0xtopus/fiber-tapering-machine/Project/FTM_v1.0/readme.txt

用于拉锥机的程序，芯片是STM32F767ZGT6，电路板和原理图请查看“Schematic”文件夹下对应的文件，程序模板使用了正点原子的emWin移植模板，由于引脚和芯片的不同进行了对应的修改以适配硬件，并在此基础上加入了对应的图形界面和逻辑控制，详情请查看“Docs”文件夹下的“CodingSpec.md”文档。
