0xtopus/fiber-tapering-machine/GUI/README.md

用于Visual Studio2019的仿真文件，主要用来查看界面显示的效果并进行微调，并没有实际的功能。

仿真示意图：



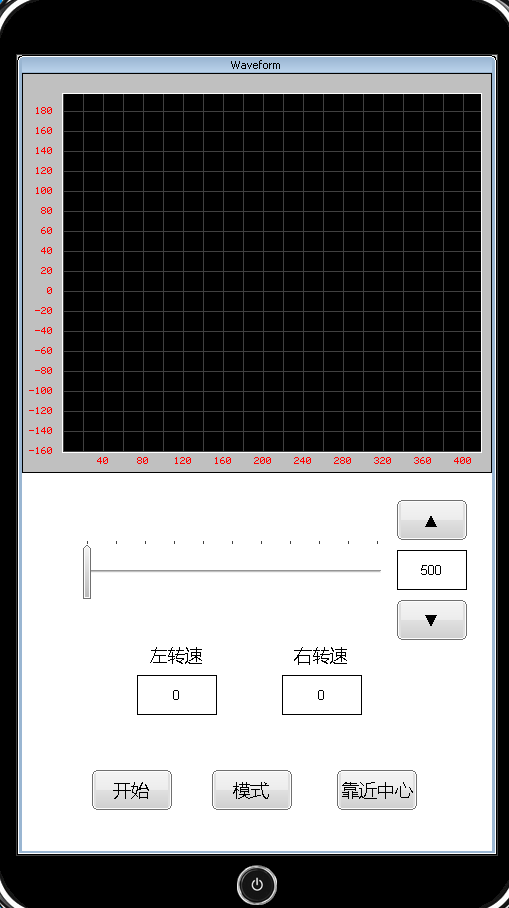
[picture p11: Docs/Images/CodingSpec_img/DualCtrl_Simu.png]
