0xtopus/fiber-tapering-machine/Docs/others/通信总线.md

# CAN总线

## 简介

全称Controller Area Network，是ISO国际标准化的**串行通信协议**。

## 总线拓扑

一、总线电平

- 显性电平
- 隐性电平

CAN控制器根据两根线上的电位差来判断总线电平。发送方通过使总线电平发生变化，将消息发送给接收方。
