0xtopus/fiber-tapering-machine/Docs/Images/SCH_v1.0.png

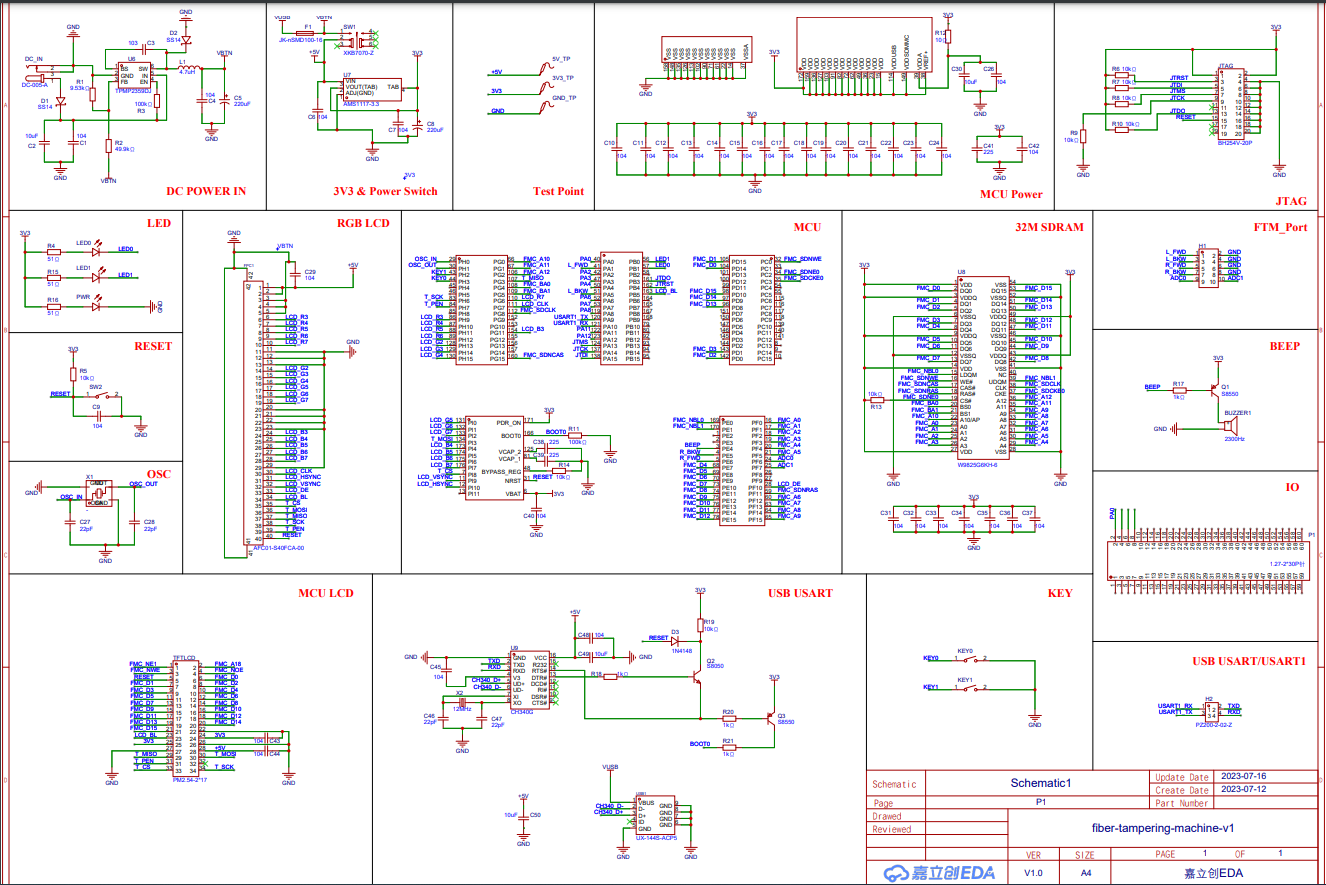
Docs/Images/SCH_v1.0.png
