0xtopus/fiber-tapering-machine/Docs/Images/Schematic_光纤拉锥机_2023-07-21.png

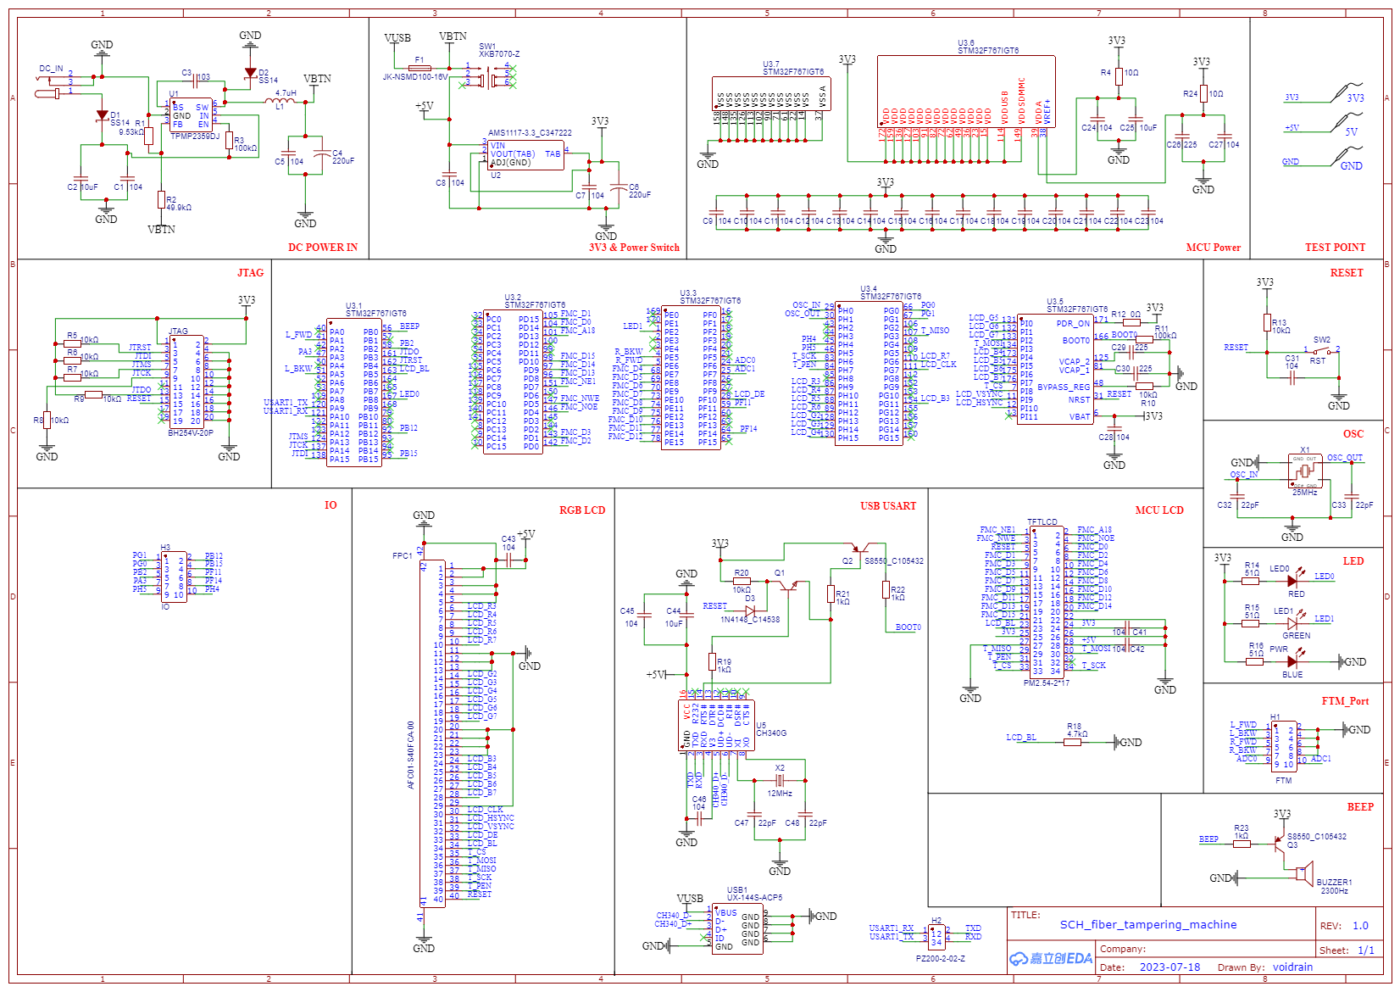
Docs/Images/Schematic_光纤拉锥机_2023-07-21.png
