0xtopus/fiber-tapering-machine/Schematic/PCB_PCB_光纤拉锥机-144pin.pdf

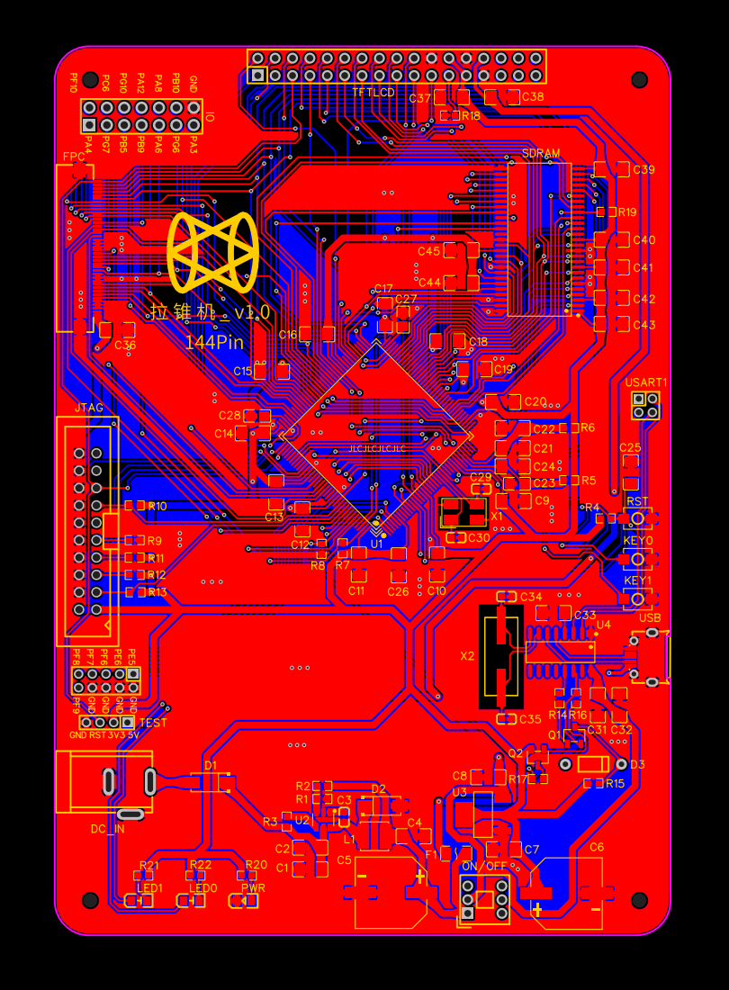
[picture p15: page 1]
