0xtopus/fiber-tapering-machine/Schematic/Schematic_光纤拉锥机-144pin.pdf

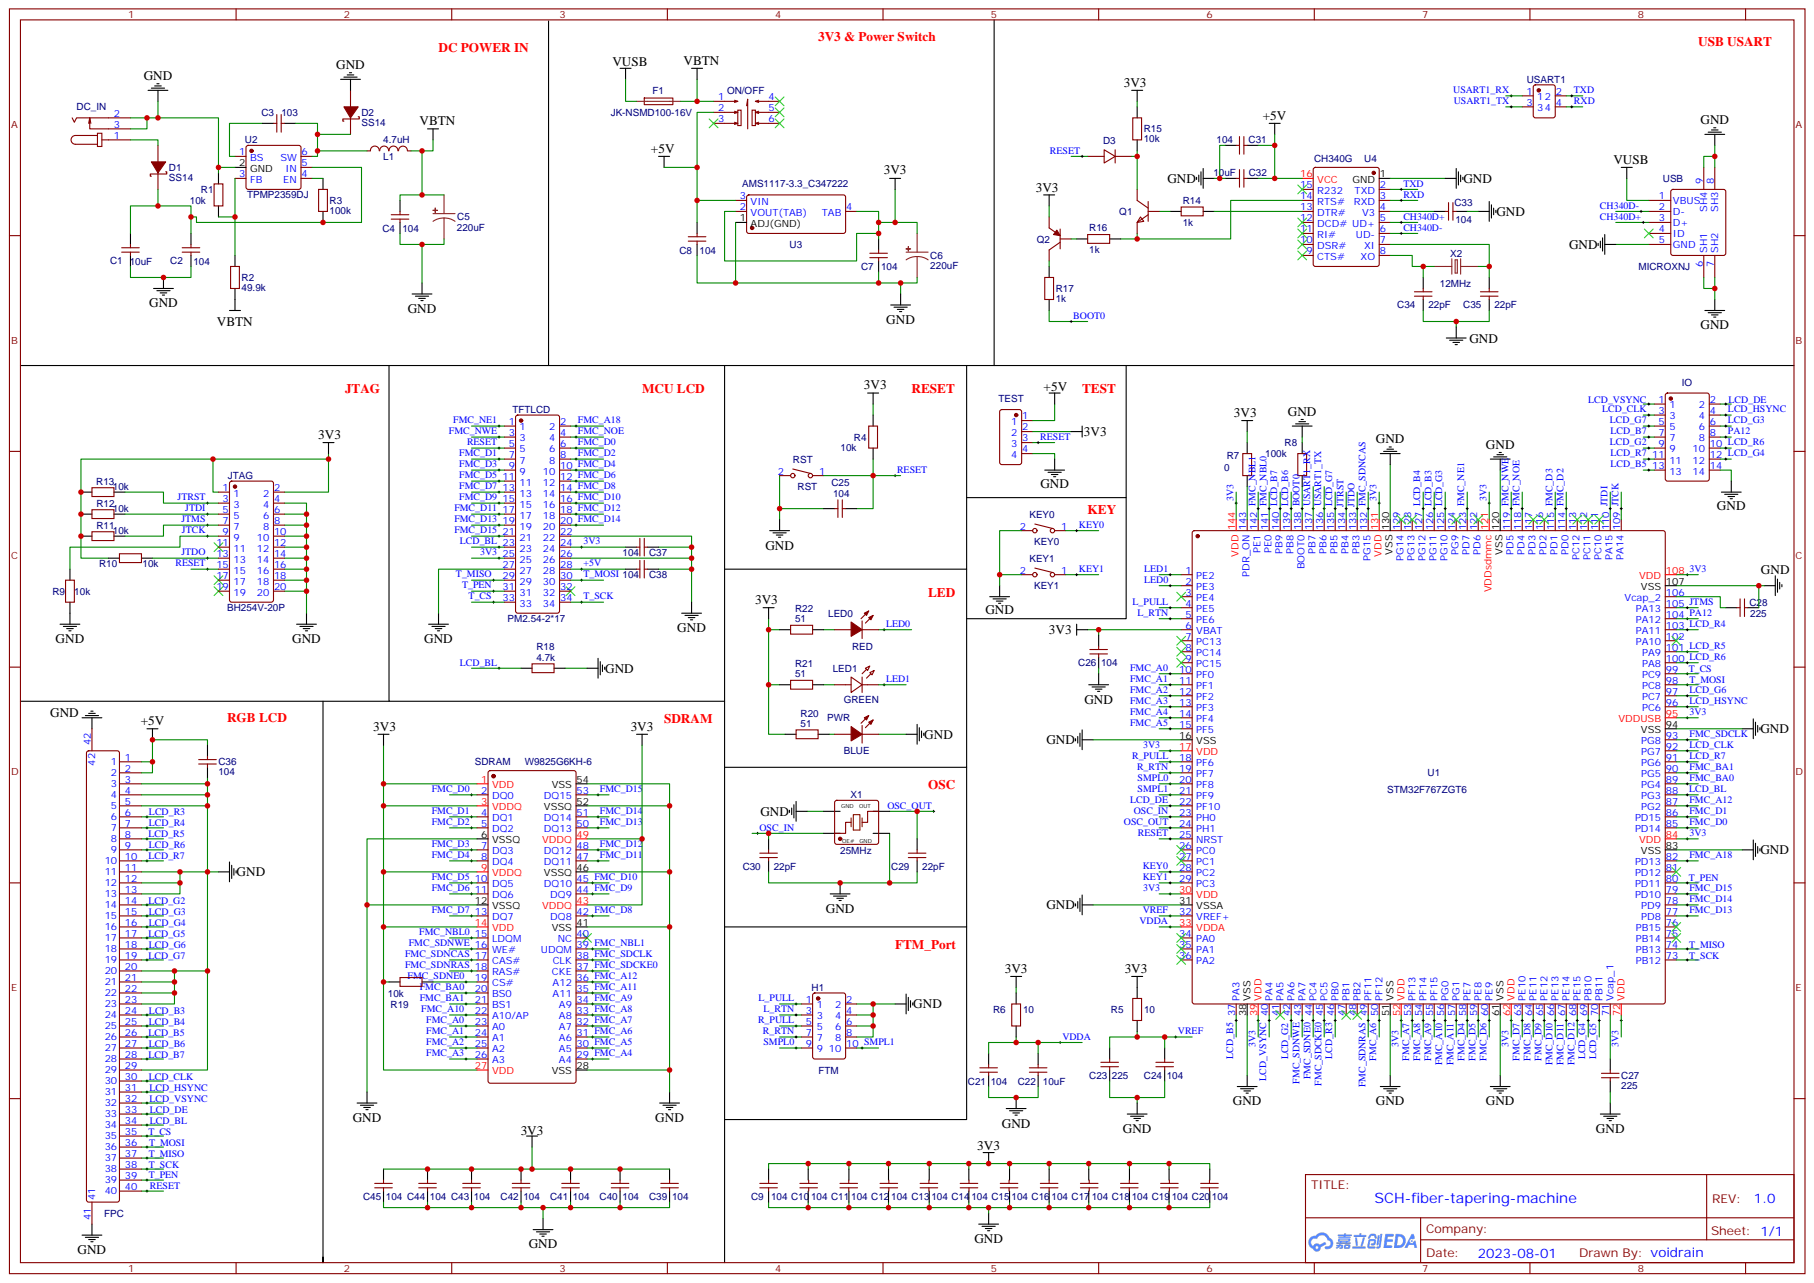
[picture p16: page 1]
