0xtopus/fiber-tapering-machine/Project/FTM_v1.0/USER/main.c

#include "sys.h"
#include "delay.h"
#include "usart.h"
#include "led.h"
#include "key.h"
#include "sdram.h"
#include "tftlcd.h"
#include "ltdc.h"
#include "mpu.h"
#include "usmart.h"
#include "malloc.h"
#include "touch.h"
#include "GUI.h"
#include "WM.h"
#include "FTM_FrameDLG.h"
#include "adc.h"
#include "includes.h"
/************************************************
 拉锥机主函数
 
 基于 ALIENTEK STM32开发板STemWin实验
 STemWin STemWin+UCOSIII移植实验
 
 UCOSIII中以下优先级用户程序不能使用，ALIENTEK
 将这些优先级分配给了UCOSIII的5个系统内部任务
 优先级0：中断服务服务管理任务 OS_IntQTask()
 优先级1：时钟节拍任务 OS_TickTask()
 优先级2：定时任务 OS_TmrTask()
 优先级OS_CFG_PRIO_MAX-2：统计任务 OS_StatTask()
 优先级OS_CFG_PRIO_MAX-1：空闲任务 OS_IdleTask()
************************************************/

//任务优先级
#define START_TASK_PRIO				3
//任务堆栈大小	
#define START_STK_SIZE 				128
//任务控制块
OS_TCB StartTaskTCB;
//任务堆栈	
CPU_STK START_TASK_STK[START_STK_SIZE];
//任务函数
void start_task(void *p_arg);

//TOUCH任务
//设置任务优先级
#define TOUCH_TASK_PRIO				4
//任务堆栈大小
#define TOUCH_STK_SIZE				128
//任务控制块
OS_TCB TouchTaskTCB;
//任务堆栈
CPU_STK TOUCH_TASK_STK[TOUCH_STK_SIZE];
//touch任务
void touch_task(void *p_arg);

//LED0任务
//设置任务优先级
#define LED0_TASK_PRIO 				5
//任务堆栈大小
#define LED0_STK_SIZE				128
//任务控制块
OS_TCB Led0TaskTCB;
//任务堆栈
CPU_STK LED0_TASK_STK[LED0_STK_SIZE];
//led0任务
void led0_task(void *p_arg);

//EMWINDEMO任务
//设置任务优先级
#define EMWINDEMO_TASK_PRIO			6
//任务堆栈大小
#define EMWINDEMO_STK_SIZE			512
//任务控制块
OS_TCB EmwindemoTaskTCB;
//任务堆栈
CPU_STK EMWINDEMO_TASK_STK[EMWINDEMO_STK_SIZE];
//emwindemo_task任务
void emwindemo_task(void *p_arg);

int main(void)
{  
    OS_ERR err;
	CPU_SR_ALLOC();
    
    Write_Through();                //Cahce强制透写
    MPU_Memory_Protection();        //保护相关存储区域
    Cache_Enable();                 //打开L1-Cache
      
	Stm32_Clock_Init(432,25,2,9);   //设置时钟,216Mhz 
	HAL_Init();				        //初始化HAL库
    delay_init(216);                //延时初始化
	uart_init(115200);		        //串口初始化
    KEY_Init();                     //按键初始化
    LED_Init();                     //初始化LED
    SDRAM_Init();                   //SDRAM初始化
	TFTLCD_Init();                  //初始化LCD
    TP_Init();				        //触摸屏初始化
    my_mem_init(SRAMIN);		    //初始化内部内存池
	my_mem_init(SRAMEX);		    //初始化外部内存池
	my_mem_init(SRAMDTCM);		    //初始化DTCM内存池

    MY_ADC_Init();                  //初始化ADC

    OSInit(&err);		            //初始化UCOSIII
	OS_CRITICAL_ENTER();            //进入临界区
	//创建开始任务
	OSTaskCreate((OS_TCB 	* )&StartTaskTCB,		//任务控制块
				 (CPU_CHAR	* )"start task", 		//任务名字
                 (OS_TASK_PTR )start_task, 			//任务函数
                 (void		* )0,					//传递给任务函数的参数
                 (OS_PRIO	  )START_TASK_PRIO,     //任务优先级
                 (CPU_STK   * )&START_TASK_STK[0],	//任务堆栈基地址
                 (CPU_STK_SIZE)START_STK_SIZE/10,	//任务堆栈深度限位
                 (CPU_STK_SIZE)START_STK_SIZE,		//任务堆栈大小
                 (OS_MSG_QTY  )0,					//任务内部消息队列能够接收的最大消息数目,为0时禁止接收消息
                 (OS_TICK	  )0,					//当使能时间片轮转时的时间片长度，为0时为默认长度，
                 (void   	* )0,					//用户补充的存储区
                 (OS_OPT      )OS_OPT_TASK_STK_CHK|OS_OPT_TASK_STK_CLR, //任务选项
                 (OS_ERR 	* )&err);				//存放该函数错误时的返回值
	OS_CRITICAL_EXIT();	            //退出临界区	 
	OSStart(&err);                  //开启UCOSIII
	while(1);
}

//开始任务函数
void start_task(void *p_arg)
{
	OS_ERR err;
	CPU_SR_ALLOC();
	p_arg = p_arg;

	CPU_Init();
#if OS_CFG_STAT_TASK_EN > 0u
   OSStatTaskCPUUsageInit(&err);  	//统计任务                
#endif
	
#ifdef CPU_CFG_INT_DIS_MEAS_EN		//如果使能了测量中断关闭时间
    CPU_IntDisMeasMaxCurReset();	
#endif

#if	OS_CFG_SCHED_ROUND_ROBIN_EN  //当使用时间片轮转的时候
	//使能时间片轮转调度功能,设置默认的时间片长度
	OSSchedRoundRobinCfg(DEF_ENABLED,1,&err);  
#endif		
	__HAL_RCC_CRC_CLK_ENABLE();		//使能CRC时钟
	WM_SetCreateFlags(WM_CF_MEMDEV);
	GUI_Init();  			//STemWin初始化
	WM_MULTIBUF_Enable(1);  //开启STemWin多缓冲,RGB屏可能会用到
	OS_CRITICAL_ENTER();	//进入临界区
	//STemWin Demo任务	
	OSTaskCreate((OS_TCB*     )&EmwindemoTaskTCB,		
				 (CPU_CHAR*   )"Emwindemo task", 		
                 (OS_TASK_PTR )emwindemo_task, 			
                 (void*       )0,					
                 (OS_PRIO	  )EMWINDEMO_TASK_PRIO,     
                 (CPU_STK*    )&EMWINDEMO_TASK_STK[0],	
                 (CPU_STK_SIZE)EMWINDEMO_STK_SIZE/10,	
                 (CPU_STK_SIZE)EMWINDEMO_STK_SIZE,		
                 (OS_MSG_QTY  )0,					
                 (OS_TICK	  )0,  					
                 (void*       )0,					
                 (OS_OPT      )OS_OPT_TASK_STK_CHK|OS_OPT_TASK_STK_CLR,
                 (OS_ERR*     )&err);
	//触摸屏任务
	OSTaskCreate((OS_TCB*     )&TouchTaskTCB,		
				 (CPU_CHAR*   )"Touch task", 		
                 (OS_TASK_PTR )touch_task, 			
                 (void*       )0,					
                 (OS_PRIO	  )TOUCH_TASK_PRIO,     
                 (CPU_STK*    )&TOUCH_TASK_STK[0],	
                 (CPU_STK_SIZE)TOUCH_STK_SIZE/10,	
                 (CPU_STK_SIZE)TOUCH_STK_SIZE,		
                 (OS_MSG_QTY  )0,					
                 (OS_TICK	  )0,  					
                 (void*       )0,					
                 (OS_OPT      )OS_OPT_TASK_STK_CHK|OS_OPT_TASK_STK_CLR,
                 (OS_ERR*     )&err);			 
	//LED0任务
	OSTaskCreate((OS_TCB*     )&Led0TaskTCB,		
				 (CPU_CHAR*   )"Led0 task", 		
                 (OS_TASK_PTR )led0_task, 			
                 (void*       )0,					
                 (OS_PRIO	  )LED0_TASK_PRIO,     
                 (CPU_STK*    )&LED0_TASK_STK[0],	
                 (CPU_STK_SIZE)LED0_STK_SIZE/10,	
                 (CPU_STK_SIZE)LED0_STK_SIZE,		
                 (OS_MSG_QTY  )0,					
                 (OS_TICK	  )0,  					
                 (void*       )0,					
                 (OS_OPT      )OS_OPT_TASK_STK_CHK|OS_OPT_TASK_STK_CLR,
                 (OS_ERR*     )&err);	                 
	OS_TaskSuspend((OS_TCB*)&StartTaskTCB,&err);		//挂起开始任务			 
	OS_CRITICAL_EXIT();	//退出临界区
}

//EMWINDEMO任务
void emwindemo_task(void *p_arg)
{
	while(1)
	{
		MainTask(); 
	}
}

//TOUCH任务
void touch_task(void *p_arg)
{
	OS_ERR err;
	while(1)
	{
		GUI_TOUCH_Exec();	
		OSTimeDlyHMSM(0,0,0,5,OS_OPT_TIME_PERIODIC,&err);//延时5ms
	}
}

//LED0任务
void led0_task(void *p_arg)
{
	OS_ERR err;
	while(1)
	{
		LED0_Toggle;
		OSTimeDlyHMSM(0,0,0,500,OS_OPT_TIME_PERIODIC,&err);//延时500ms
	}
}
