0xtopus/fiber-tapering-machine/Project/FTM_v1.0/HARDWARE/TOUCH/gt9271.h

#ifndef __GT9271_H
#define __GT9271_H	
#include "sys.h"	
//////////////////////////////////////////////////////////////////////////////////	 
//10.1寸电容触摸屏-GT9271 驱动代码	   
//版本：V1.1
//更新说明：适配拉锥机							  
////////////////////////////////////////////////////////////////////////////////// 



//IO操作函数	 
#define GT9271_RST(n)  		 (n?HAL_GPIO_WritePin(GPIOC,GPIO_PIN_9,GPIO_PIN_SET):HAL_GPIO_WritePin(GPIOC,GPIO_PIN_9,GPIO_PIN_RESET))//GT9147复位引脚
#define GT9271_INT    		 HAL_GPIO_ReadPin(GPIOD,GPIO_PIN_11)  //GT9147中断引脚		
 
//I2C读写命令	
#define GT9271_CMD_WR 		0X28    	//写命令
#define GT9271_CMD_RD 		0X29		//读命令
  
//GT9271 部分寄存器定义 
#define GT9271_CTRL_REG 	0X8040   	//GT9271控制寄存器
#define GT9271_CFGS_REG 	0X8047   	//GT9271配置起始地址寄存器
#define GT9271_CHECK_REG 	0X80FF   	//GT9271校验和寄存器
#define GT9271_PID_REG 		0X8140   	//GT9271产品ID寄存器

#define GT9271_GSTID_REG 	0X814E   	//GT9271当前检测到的触摸情况
#define GT9271_TP1_REG 		0X8150  	//第一个触摸点数据地址
#define GT9271_TP2_REG 		0X8158		//第二个触摸点数据地址
#define GT9271_TP3_REG 		0X8160		//第三个触摸点数据地址
#define GT9271_TP4_REG 		0X8168		//第四个触摸点数据地址
#define GT9271_TP5_REG 		0X8170		//第五个触摸点数据地址 
#define GT9271_TP6_REG 		0X8178		//第五个触摸点数据地址 
#define GT9271_TP7_REG 		0X8180		//第五个触摸点数据地址 
#define GT9271_TP8_REG 		0X8188		//第五个触摸点数据地址 
#define GT9271_TP9_REG 		0X8190		//第五个触摸点数据地址 
#define GT9271_TP10_REG 	0X8198		//第五个触摸点数据地址  
 
 
u8 GT9271_Send_Cfg(u8 mode);
u8 GT9271_WR_Reg(u16 reg,u8 *buf,u8 len);
void GT9271_RD_Reg(u16 reg,u8 *buf,u8 len); 
u8 GT9271_Init(void);
u8 GT9271_Scan(u8 mode); 
#endif
