0xtopus/fiber-tapering-machine/Project/FTM_v1.0/HARDWARE/TOUCH/ctiic.h

#ifndef __MYCT_IIC_H
#define __MYCT_IIC_H
#include "sys.h"	    
//////////////////////////////////////////////////////////////////////////////////	 
//本程序只供学习使用，未经作者许可，不得用于其它任何用途
//ALIENTEK STM32开发板
//电容触摸屏-IIC 驱动代码	   
//正点原子@ALIENTEK
//技术论坛:www.openedv.com
//创建日期:2015/12/30
//版本：V1.0
//版权所有，盗版必究。
//Copyright(C) 广州市星翼电子科技有限公司 2014-2024
//All rights reserved									  
//********************************************************************************
//无
////////////////////////////////////////////////////////////////////////////////// 	

//IO方向设置
#define CT_SDA_IN()  {GPIOC->MODER&=~(3<<(8*2));GPIOC->MODER|=0<<8*2;}	//PC8输入模式
#define CT_SDA_OUT() {GPIOC->MODER&=~(3<<(8*2));GPIOC->MODER|=1<<8*2;} 	//PC8输出模式
//IO操作函数	 
#define CT_IIC_SCL(n) (n?HAL_GPIO_WritePin(GPIOB,GPIO_PIN_12,GPIO_PIN_SET):HAL_GPIO_WritePin(GPIOB,GPIO_PIN_12,GPIO_PIN_RESET))//SCL
#define CT_IIC_SDA(n) (n?HAL_GPIO_WritePin(GPIOC,GPIO_PIN_8,GPIO_PIN_SET):HAL_GPIO_WritePin(GPIOC,GPIO_PIN_8,GPIO_PIN_RESET))//SDA	 
#define CT_READ_SDA   HAL_GPIO_ReadPin(GPIOC,GPIO_PIN_8)//输入SDA 
 

//IIC所有操作函数
void CT_IIC_Init(void);                	//初始化IIC的IO口				 
void CT_IIC_Start(void);				//发送IIC开始信号
void CT_IIC_Stop(void);	  				//发送IIC停止信号
void CT_IIC_Send_Byte(u8 txd);			//IIC发送一个字节
u8 CT_IIC_Read_Byte(unsigned char ack);	//IIC读取一个字节
u8 CT_IIC_Wait_Ack(void); 				//IIC等待ACK信号
void CT_IIC_Ack(void);					//IIC发送ACK信号
void CT_IIC_NAck(void);					//IIC不发送ACK信号

#endif
