0xtopus/fiber-tapering-machine/(commit log)

2023-07-07 add primitive dual motor speed control
2023-07-08 finish control and display part for dual motor control mode
2023-07-08 add primitive single motor start/stop control
2023-07-09 if things go wrong roll back to this version
    [motorcontrol.c, motorcontrol.h, single_motorDLG.c]
2023-07-11 update objectives, ready to design PCB
2023-07-16 Update README, documents, program and schematic
2023-07-21 update new schemactic and PCB
2023-07-24 fix manual control bugs and update PCB design
    [main.c, motorcontrol.c, timer.c]
2023-07-29 add primitive ADC sampling for test
2023-08-02 add a new project with uCOS and fft for adc
2023-08-09 add new notes for adc and dma, update objectives
2023-08-20 fix a comment and update note
    [tftlcd.c]
2023-08-20 Add new schematic and pcb
