0xtopus/fiber-tapering-machine/(notices)

Notices in the files:
Project/FTM_v1.0/HARDWARE/TOUCH/gt9147.c:
Copyright(C) ¹ãÖÝÊÐÐÇÒíµç×Ó¿Æ¼¼ÓÐÏÞ¹«Ë¾ 2014-2024
All rights reserved
Project/FTM_v1.0/SYSTEM/usart/usart.c:
Copyright(C) ¹ãÖÝÊÐÐÇÒíµç×Ó¿Æ¼¼ÓÐÏÞ¹«Ë¾ 2009-2019
